eSpark-Backup/tonyajode-tabletdesign/Documents/_Images/download (1) - Copy.jpg

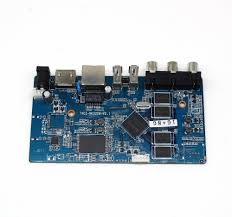
Documents/_Images/download (1) - Copy.jpg
