eSpark-Backup/tonyajode-tabletdesign/Documents/_Images/images (1).jpg

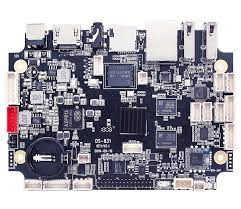
Documents/_Images/images (1).jpg
