eSpark-Backup/tonyajode-tabletdesign/README.md

# TonyAjode-TabletDesign
To develop a custom Android Tablet that meets client's requirements
## Reference Links:
### Client shared link:
https://mega.nz/folder/z5Y0XJoY#Gf70UQKzT3QTy8h_Zp9odA
### i.MX 8M refernce design links: https://media.digikey.com/pdf/Data%20Sheets/NXP%20PDFs/MCIMX8M-EVK_Schematic.pdf
### Alternate SoM:
1) https://www.compulab.com/products/computer-on-modules/ucm-imx8-nxp-i-mx-8m-som-system-on-module-computer/
2) https://www.variscite.com/product/system-on-module-som/cortex-a72/var-som-mx8-nxp-freescale-i-mx8/
### 3G modem link:
http://www.ebvnews.ru/doc16/SIM7100_DS.pdf
### Samsung GT-P6800 Galaxy Tablet schematic:
(for reference only) https://drive.google.com/file/d/1cv6nKJzWq3uBpqava95Kh4lrrErxx5Bf/view
### TI's Tablet (multimedia) ICs and reference designs:
https://www.ti.com/solution/tablet-multimedia
