eSpark-Backup/tonyajode-tabletdesign/Design-Files/Tony_Tablet.PcbDoc.htm

Reporting Options

# File in Previous Format

Date | : | 10/4/2021
Time | : | 10:42:58 AM
Filename | : | D:\eSpark\TonyAjode-TabletDesign\Design-Files\Tony_Tablet.PcbDoc

Version | Warning

This file was generated by an earlier version of the software
