eSpark-Backup/tonyajode-tabletdesign/Design-Files/Tablet_Design.PcbDoc.htm

Reporting Options

# File in Previous Format

Date | : | 8/11/2021
Time | : | 11:00:41 AM
Filename | : | D:\eSpark\TonyAjode-TabletDesign\Design-Files\Tablet_Design.PcbDoc

Version | Warning

This file was generated by an earlier version of the software
