eSpark-Backup/tonyajode-tabletdesign/Documents/Tablet Design Report.docx

# Tablet Design Report

# Current Design Description:

## 1. Power Section:

The power section is divided into three parts namely;

- MCU Core power
- USB power
- RTC Section

### a) MCU Core power:

Main Component:

ETA3451D2I-T: 6V/3.5A, Fast Response, Adaptive COT Step-Down Converter in Tiny DFN2x2

Description:

This section is responsible for supplying DC power to the core of SoM. The ETA3451D2I-T IC is being used in this section to produce 1V output. ETA3451D2I-T is a high frequency synchronous Step-Down converter with up to 91% efficiency for low output voltage and a 3.5A Max output current limit.
Link:

http://www.etasolution.com/upload/201712/15/201712151617531412.pdf

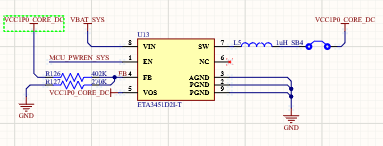
[picture p3: figure]

Figure 1

### b) USB Power Section:

Main Component:

MP3221GJ-Z IC: 2.7A, 1.2MHz, High-Efficiency Step-Up Converter with Input Disconnect

Description:

This section uses MP3221GJ-Z IC to generate input supply for the chipsets being used in the USB section. The MP3221 is a 1.2MHz frequency, 6-pin TSOT23 current mode step up converter intended for small, low power applications. It offers a disconnect feature that allows the output to be completely discharged, thus allowing the part to draw less than 1µA off current in shutdown mode. The circuit uses a feedback combination of 536K and 100K resistors to produce a 5V/1A output.

Link: https://www.monolithicpower.com/en/documentview/productdocument/index/version/2/document_type/Datasheet/lang/en/sku/MP3221/document_id/1118

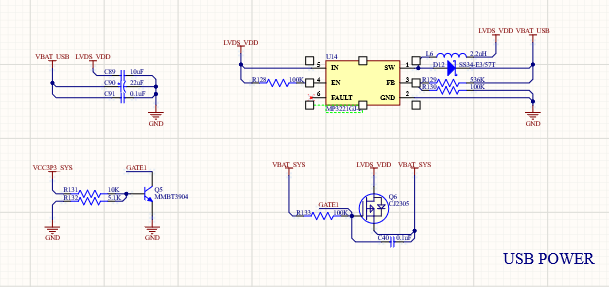
[picture p4: figure]

Figure 2

### c) RTC Section:

Main Component:

S-1206B18-M3T1U: ultra-low current consumption and low dropout CMOS voltage regulator

Description:

This section is designated to provide power to the RTC clock of the SoM. S-1206B18-M3T1U is being used to generate 1.8V output. The S-1206 Series is a positive voltage regulator with ultra-low current consumption, low dropout voltage, high-accuracy output voltage, and 250 mA output current developed based on CMOS technology. It operates at ultra-low current consumption of 1.0 A (typ.) and has built-in overcurrent protection circuit that prevents the load current from exceeding the current capacity of the output transistor.
Link:

https://www.ablic.com/en/doc/datasheet/voltage_regulator/S1206_E.pdf

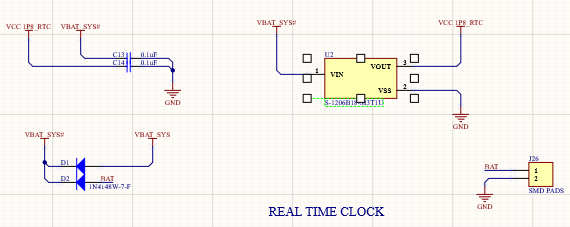
[picture p5: figure]

Figure 3

## 2. Audio Section:

Audio section deals with the input and output audio signals and is further divided into three different sections.

### a) Mic Section:

Main Component:

POM-2738P-R: Condenser mic, analogue, omni -38db 6mm d

Description:

It is the main input source of audio for the tablet. A POM-2738P-R is used which is an electret condenser type microphone and gives analogue output. The Mic output goes straight into the audio codec through MIC1P and MIC1N netlabels. MICBIAS provides power to POM-2738P-R through ALC5621.

Link:

https://www.puiaudio.com/media/SpecSheet/POM-2738P-R.pdf

Figure 4

### b) Audio Codec Section:

Main component:

ALC5621: I2S audio codec + 1.3w class ab/d mono speaker amplifier + headphone amplifier

Description:

The ALC5621 is a highly-integrated I2S/PCM interface audio codec with multiple input/output ports and is designed for mobile computing and communications. This IC will be used in the audio codec section to provide good quality sound output. It also has a Stereo Hi-Fi DAC for playback and Stereo ADC for recording via the I2S/PCM interface. The chip is connected to SoM via I2S interface in our design.
The ALC5621 AVDD operates at supply voltages from 2.3V to 3.6V. DVDD operates from 1.71 to 3.6V, and SPKVDD operates from 2.3 to 5V. To extend battery life, each section of the device can be powered down individually under software control. Leakage current in maximum power saving state is less than 10μA.

Link:

https://mega.nz/folder/z5Y0XJoY#Gf70UQKzT3QTy8h_Zp9odA/folder/O04ixZyI

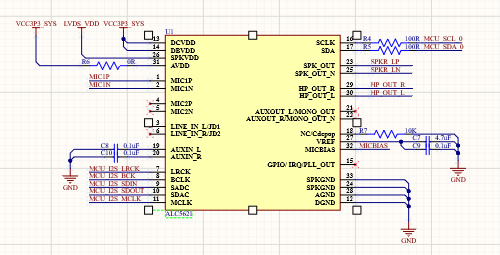
[picture p6: figure]

Figure 5

### c) Headphone Section:

Main Component:

SJ-43504-SMT-TR: mid mount audio jack

Description:

This section has a SJ-43504-SMT-TR audio jack for Stereo headphone output. The output signal HP_OUT_L and HP_OUT_R goes directly to this connector. The audio jack is powered up with a 3.3V supply from VCC3P3_SYS signal from X4418.

Link:

https://www.cuidevices.com/product/resource/sj-43504-smt-tr.pdf

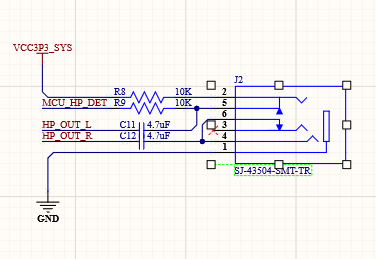
[picture p7: figure]

Figure 6

## 3. 3G Section:

Main Component:

SIM7100: multi-band TDD-LTE/FDD-LTE/WCDMA/GSM/GNSS SMT type module.

693043020611: 6 Position Card Connector NANO SIM Surface Mount, Right Angle Gold

Description:

We are using SIM7100AS2-10671 as a 3G modem in this tablet. The module is powered up directly through the battery. Some multilayer ceramic chip (MLCC) capacitors (0.1/1uF) with low ESR in high frequency band can be used for EMC.

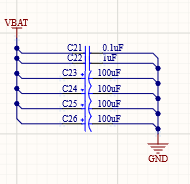
[picture p8: figure]

Figure 7

SIM7100 has a 1.8V I/O level. To match the I/O levels of SoM which operate at 3.3V, level shifters are being used to bridge signals between the two devices.

Figure 8

2 UFL connectors are provided to connect the main and GNNS antenna for proper RF connectivity.

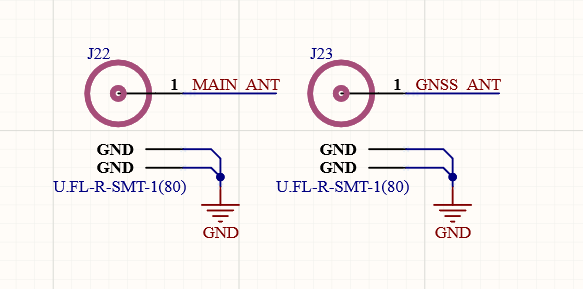
[picture p9: figure]

Figure 9

Module is able to make and receive voice calls, data calls, SMS and make GPRS/WCDMA/HSPA+/LTE traffic. For this purpose, 693043020611 ESIM has been attached on the PCB with proper ESD protection as shown below.

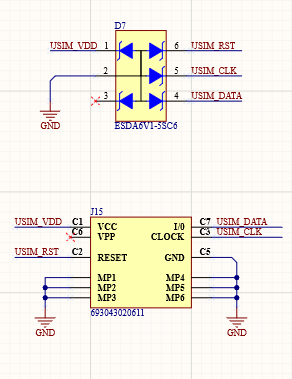
[picture p10: figure]

Figure 10

The SIM7100 module is communicating with the G4418 SoM via USB interface. The SIM7100 contains a USB interface compliant with the USB2.0 specification as a peripheral, but the USB charging function is not supported. The connections are made with proper ESD protection diodes.

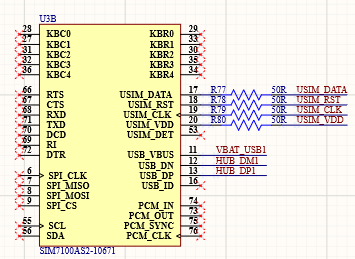
[picture p11: figure]

Figure 11

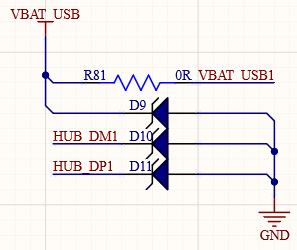
[picture p12: figure]

Figure 12

Link:

https://www.we-online.de/katalog/datasheet/693043020611.pdf

http://www.ebvnews.ru/doc16/SIM7100_DS.pdf

## 4. Main Processing Section:

The choice of CPU is one of the critical decisions of all. It is the brain of the entire module, driving all the I/O peripherals, display and touch screen etc. With the ongoing digitization and introduction of more complex systems, old embedded chips are being replaced by advanced systems and modules. One such unique product is a System on Module.
We are using X4418 module in this tablet which consists of S5P4418 SoM, AXP228 PMIC, and some memory chips.

### a) Overview of S5P4418 SoM:

The module used in the design is the X4418 board equipped with Samsung S5P4418 system on module, AXP228 PMIC and memory chips as main elements. The SoM is high performance, cost effective and low power embedded system CPU module and uses a 32-bit RISC processor which makes it suitable to be embedded in tablet pc, mobile phones, cars, learning machine, POS machine, game machine, industry monitoring and many other projects.

### b) Key Features:

Following are some core features of the processing module.

CPU: | ARM Cortex-A9 Quad-Core
Speed: | 1.4 GHz
Memory | LPDDR1, LPDDR2, DDR2 and DDR3
EMMC | 8GB(Default) (4GB and 16GB optional)
Multi-media decode | H.263, H.264, MPEG1, MPEG2, MPEG4, VC1, VP8, Theora, AVS, RV8/9/10, MJPEG
Multi-media codec | H.263, H.264, MPEG4, MJPEG
Max resolution | 2048*1280
ADC | 8 channel 12 bit 0~1.8V
RAM | 1GB DDR3

The ARM Cortex-A9 Quad-Core is 50% faster than the Cortex-A8-core. It provides a 6.4 GB/s memory bandwidth for heavy traffic operations such as a 1080p video encoding and decoding, 3D graphics display and high-resolution image signal processing with full HD display. Software designers can fully access the memory resources as the processor supports dynamic virtual address mapping.

The module supports Dual Display up to 2048x1280, TFT-LCD, LVDS, HDMI 1.4a, MIPI-DSI output. It also provides a 3.3V output voltage at it's GPIOs which is quite commonly used among other integrated devices. Hence the device can be interfaced with a wide range of other chips sets. The Samsung S5P4418 has various boot modes including External Static Memory Boot, SPI Flash/EEPROM, NOR, USB and UART boot options.

### c) Available Interfaces:

The X4418 module supports 3ch I2S, SPDIF Rx/Tx, 3ch I2C, 3ch SPI, 8ch 12bit ADC, 3ch PWM and GPIOs, 1ch PPM. It also offers 1ch USB 2.0 Host, 1ch USB 2.0 OTG, 1ch USB HSIC Host.

### d) Software compatibility:

The Samsung S5P4418 system on module support three main operating systems: android4.4.2 OS, linux3.4.39 + QT5.4 system and ubuntu12.04.

### e) Electrical characteristics:

Some important voltage and current rating values are mentioned below:

Signal Description | Typical value
DC supply voltage for CORE | 1-1.2V
DC supply voltage for RTC | 1.8V
DC supply voltage for 3.3V IO | 3.3V
DC supply voltage for 2.8V VID0, VID2/SD2, Ethernet MAC | 2.8V
DC In/Out Current | 20mA max

### f) SoM Power Section:

The G44418 module uses AXP228 PMIC optimized for a multi-core high-performance system. It is designed to charge a single cell Li-battery (Li-ion or Li-polymer) application that requires multi-channel power conversion outputs. AXP228 comes with an adaptive USB3.0-compatible Flash Charger that supports up to 94% efficiency and 2.2A charge current.

What are the main features of PMIC?

It provides an easy and flexible power management solution for multi-core processors to meet the increasingly complex and accurate requirements of power control. AXP228 provides multiple-channel 12-bit ADC for voltage/current/temperature monitoring and integrates protection circuits such as OVP, UVP, OTP, and OCP. The VOUT current available before loading the battery is 3A.

How does the charging process work?

When the battery voltage is lower than 3.0V, the charger will change to pre-charge mode, where the charge current is 1/10 of a pre-set current value. If the battery voltage fails to reach 3.0V within 40 mins (adjustable in REG34H) the charger will automatically enter battery activation mode. Once the battery voltage is above 3.0V, the charger will enter constant current charge mode.

The charging current is 2.2A whereas VCC3V3_SYS is the 3.3V output which provides up to 1.4A current.

## 5. Camera Section:

Main Component:

0524352471: 24 position 0.5mm FPC connector

Description:

The camera section is currently designed for a single rear camera of the tablet. It uses a 0524352471 FPC connector to place in the camera. The camera signals directly connect to the SoM camera input pins. The G4418 development board has provided a single 24PIN DVP camera interface which is implemented in the current circuit. It is capable of supporting OV and HIMAX cameras.

Link:

https://www.molex.com/pdm_docs/sd/524352471_sd.pdf

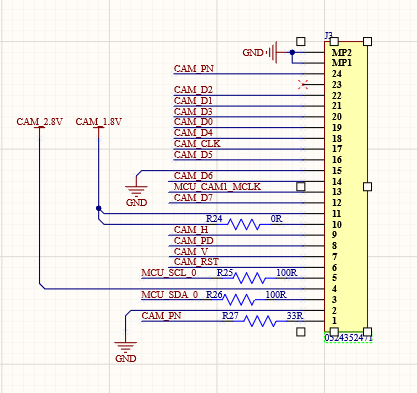
[picture p13: figure]

Figure 13

## a) Key points to consider:

- Block diagram shows 2 cameras of 2MP and 5MP for front and rear view respectively. Rear camera should have a I2C interface and the front camera should be connected through MCS1. If two cameras are required then an extra connector needs to be added.

Some options for camera selection are mentioned below.

- Link 1: https://www.sparkfun.com/products/15570
- Link 2: https://www.aliexpress.com/item/32843271086.html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 (Front)
- Back 5MP: https://www.aliexpress.com/item/33029896473.html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

## 6. LCD Section:

Currently, the design supports an RGB LCD. An FPC connector 4-1734592-2 is attached as an LCD matting connector. All pins are connected to the SoM. The SoM also supports the LVDS interface for LCDs. Depending on the selection of LCD, a dedicated backlight driver might be required.

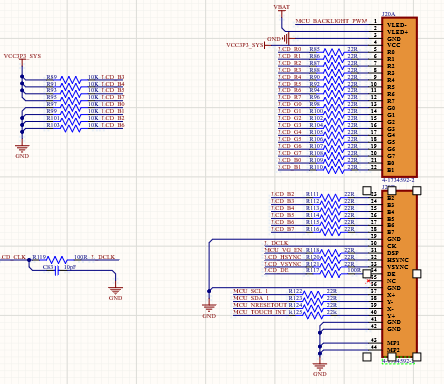
[picture p14: figure]

Figure 14

### Compatible LCDs:

Here are some options from the client's suggested IC that can be used for designing a tablet.

- AT043TN24 V.1 with touch panel: https://www.aliexpress.com/item/32560082998.html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,searchweb201602_,searchweb201603 (RGB)
- NT116WHM-N10: https://www.aliexpress.com/item/32878065947.html (LVDS based, need to change pin configuration for this one)
- HSD050IDW1-A: https://www.aliexpress.com/item/32811367794.html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,searchweb201602_,searchweb201603_ (without touch screen digitizer)

https://www.aliexpress.com/item/33041667425.html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,searchweb201602_,searchweb201603_ (with touch screen digitizer)

## 7. Memory Section:

The memory section encompasses two SD card connectors 114-00841-68 which will be connected to the relevant pins of G4418 SoM. The connectors are powered through the 3.3V supply provided by the power section of the SoM. All data signals of the SD card are pulled up using a 47K resistor array.

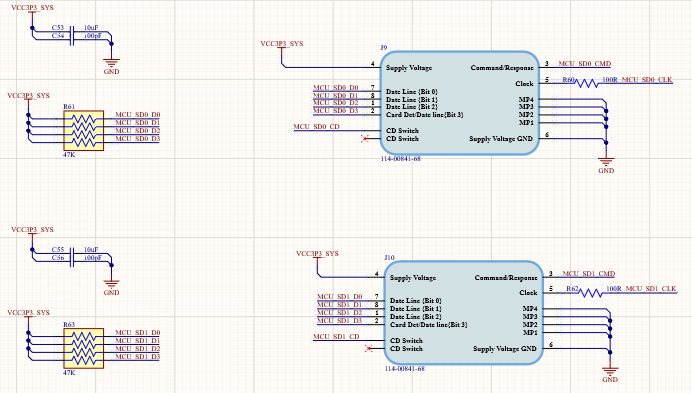
[picture p15: figure]

Figure 15

## 8. USB Section:

The USB section is divided into the following sub sections.

- USB Host Section
- USB OTG section

At present, there is one USB OTG channel and 3 USB host channels available.

### a) USB Host Section:

Main Component:

GL850G: USB 2.0 Hub Controller

87583-2010BLF: USB-A (USB TYPE-A) USB 2.0 Receptacle Connector 4 Position Surface Mount, Right Angle

Description:

This section would serve as a “master” USB device, to which other “client” peripherals can be attached. 3 USB Tyoe A connectors 87583-2010BLF are present in the schematic and are only connected to USB host IC. The GL850G USB host IC is being used which embeds an 8-bit RISC processor to manipulate the control/status registers and respond to the requests from the USB host. Since the pins are bidirectional, 3 channels of host IC are connected to micro-USB connectors and the remaining two channels, DX0 and DX1, are connected to MCU and 3G modem respectively.

Link:

https://datasheet.lcsc.com/szlcsc/Genesys-Logic-GL850G-HHY22_C136617.pdf

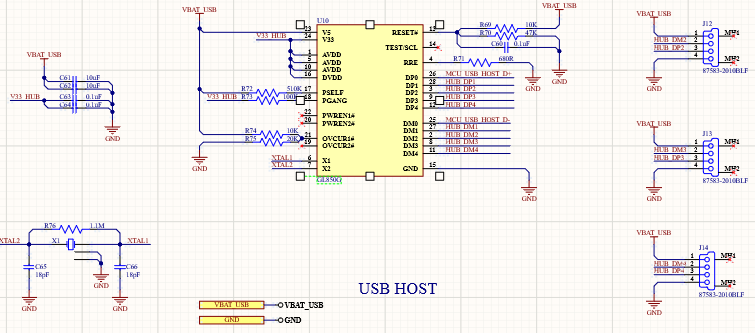
[picture p16: figure]

Figure 16

### b) USB OTG section:

Main Components:

SY6280: power distribution switch

10118194-0001LF: micro–B USB 2.0 receptacle connector

Description:

With USB On-The-Go, you can connect external peripheral devices to this tablet such as keyboard and storage devices. We are using the SY6280 chipset which is a low loss power distribution switch. The USB input uses a 10118194-0001LF micro–B USB 2.0 receptacle connector.

The SY6280 will receive 5V from the USB power section. This will control supply to the OTG and will be controlled by the main processing unit.

Link:

https://img.ozdisan.com/ETicaret_Dosya/470612_2154920.PDF

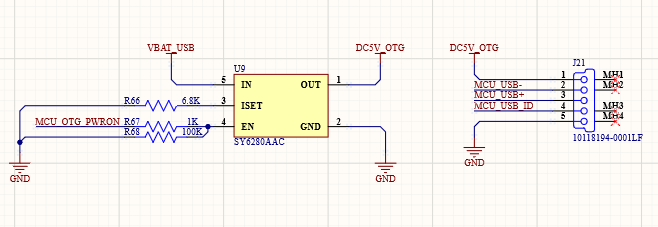
[picture p17: figure]

Figure 17

## 9. Input Section:

Input section consists of the following sub sections:

- Keys Button Section
- Sensor Section

### a) Keys Button Section:

Main Component:

TL3301NF160QG/TR: Tactile Switch SPST-NO Top Actuated Surface Mount

Description:

The tablet will have TL3301NF160QG/TR as 2 volume keys, a power button and a reset switch which are provided in this section. Switches for back and menu function are also given.

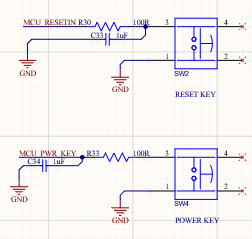
[picture p18: figure]

Figure 18

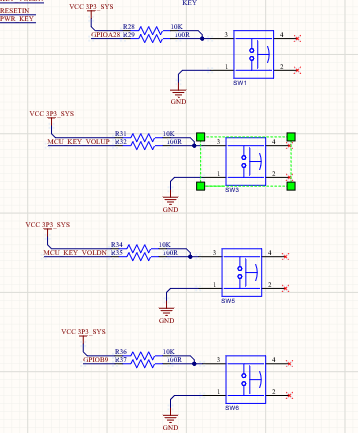
[picture p19: figure]

Figure 19

### b) Sensor Section:

Main Components:

ICM-42688-P: 6 axis IMU senor

VEML6030-GS15: light sensor IC

Description:

The tablet currently has a 6 axis IMU sensor ICM-42688-P and a light sensor VEML6030-GS15. Both sensors are connected through the I2C 2 interface of the SoM with different address lines.

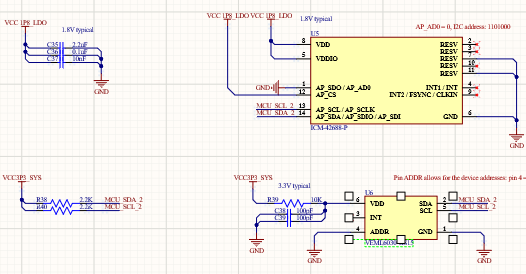
[picture p20: figure]

Figure 20

According to the block diagram a compass is also required which needs to be added.

Figure 21

Link:

https://www.vishay.com/docs/84366/veml6030.pdf

https://product.tdk.com/system/files/dam/doc/product/sensor/mortion-inertial/imu/data_sheet/ds-000347-icm-42688-p-v1.2.pdf

## 10. Connector Section:

Main Component:

DC-005-5A-2.5-SMT: DC barrel jack

0527460471: FPC connector

Description:

The connector section consists of all the important connectors for input power. We have added a DC barrel jack DC-005-5A-2.5-SMT for power adapter and an FPC connector 0527460471 and SMD pads for battery input. The input is connected to necessary bulk capacitance for a stable supply. Battery is expected to be 3.7V Lipo whereas the adaptor will provide 5V power input. The input signals from this section connect to the main controller section which has a built-in power management circuitry with battery charging facility.

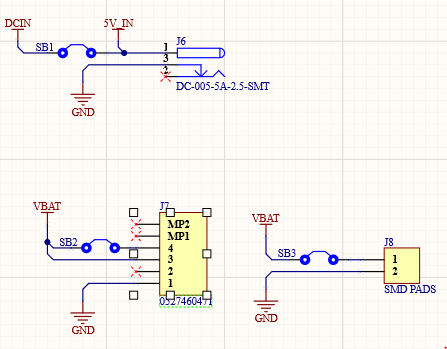
[picture p21: figure]

Figure 22

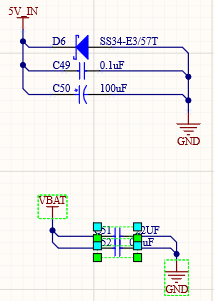
[picture p22: figure]

Figure 23

# Missing Characteristics Of the System:

Following components/circuits needs to be added to the current design as per the instructions given in block diagram provided by client.

- Another camera interface needs to be added for front view.
- Backlight LED driver depending on the choice of LCD.
- Debug FPC connector needs to be added.
- There should be a speaker connected to the audio codec.
- There is no Bluetooth or WiFi feature available in the design.
- Not enough GPIOs are available for connecting SIM7100. The RESET pin, PWRKEY (which enables the module) and flight mode pin (which controls RF function) are not connected to the SoM.
- Extra SD card connector needs to be removed from the design. The tablet can work well with a single SD card.

# Alternate Suggestions for SoM G4418:

Here are some other efficient alternates to the current processing unit being used in the design.

## 1. VAR-SOM-MX6:

### a) Overview:

The VAR-SOM-MX6 is a high-performance System-on-Module. It provides an ideal building block that easily integrates with a wide range of target markets requiring rich multimedia functionality, powerful graphics and video capabilities, as well as high-processing power. Compact, cost effective and with low power consumption, VAR-SOM-MX6 secures an Intel Atom performance level.

Datasheet Link: https://www.variscite.com/wp-content/uploads/2017/12/VAR-SOM-MX6_datasheet.pdf
Reference Design: https://www.variscite.com/wp-content/uploads/2017/12/V2_VAR-MX6CustomBoard-Schematics.pdf

### b) Key Features:

- Freescale i.MX6 series SoC (Single/Dual/Quad/Quad Plus ARM® Cortex™-A9 Core, 1.2 GHz)
- Up to 4GB DDR3 RAM
- Up to 1GB NAND Flash for storage memory / boot
- Up to 64GB eMMC storage
- 2 x LVDS display interface
- HDMI V1.4 interface
- 1 x MIPI DSI.
- Touch panel interface.
- Parallel & serial camera interface
- On-board 10/100/1000 Mbps Ethernet PHY
- TI WiLink8 2.4/5GHz WLAN (802.11 a/b/g/n) / BT-BLE 4.1 with CSA2 support
- and optional MIMO
- 1 x USB 2.0 host, 1 x OTG
- 1 x SD/MMC.
- Serial interfaces (SPI, I2C, UART, I2S,)
- CAN Bus.
- Stereo line-In / headphones out
- Digital microphone
- Single 3.3 V power supply
- 67mm x 51mm, 200 pin SO-DIMM Connector

### c) Advantages over G4418 module:

Here are some plus points of using the Var-SoM-MX6:

- The module has TLV320AIC3106 which is a low-power, highly integrated stereo audio codec with stereo headphone amplifier, as well as multiple inputs and outputs programmable in single-ended or fully differential configurations The VAR-SOM-MX6 exposes the following interface of the TLV320AIC3106:
1. Headphone
2. Line-in
3. Digital microphone
- The VAR-SOM-MX6 contains TI’s WL183xMOD WiLink, a high performance 2.4/5 GHz IEEE 802.11 a/b/g/n Bluetooth 4.1/BLE with CSA2 support radio module, with optional Dual Band and MIMO support. The modules support improved performance over WiFi in bit rates reaching 100Mbps (UDP) and 80Mbps (TCP).
- The VAR-SOM-MX6 features Freescale’s PMPF0100 as a Power Management Integrated circuit (PMIC) which regulates all power rails required on SoM from a single 3.3 V power supply. The PMIC is fully programmable via the I2C interface.
- The VAR-SOM-MX6 exposes a 200-pin SO–DIMM mechanical standard interface. The recommended mating connector for baseboard interfacing are:

1. CONCRAFT - 0701A0BE52E

2. Tyco Electronics-1565917-4

In addition to the 200-pin SO-DIMM interface VAR-SOM-MX6 exposes a 40-pin FFC connector. The recommended mating cable is Molex 21020-0427 or equivalent.

- The VAR-SOM-MX6 features a 4-wire resistive touch panel interface which is compatible with 4-wire resistive touch screens, pen-detection and nIRQ generation and supports several schemes of measurement, averaging to filter noise.
- The SoM supports JTAG for debugging and test controlling with maximum security
- It has a 4GB of DDR3 compared to a 1GB DDR3 of G4418 and a 64GB eMMc compared to 8GB in G4418. : The VAR-SOM-MX6 is available with up to 1GB of SLC NAND FLASH memory.

## 2. UCM-iMX8:

### a) Overview:

UCM-iMX8 is an ultra-miniature form-factor and high efficiency module which is ideal for space constrained and portable systems. The module uses i.MX 8M family of processors features advanced implementation of a quad ARM® Cortex®- A53 core, which operates at speeds of up to 1.5 GHz. A general-purpose Cortex®-M4 core processor is for low-power processing.

### b) Key Features:

Features | Details
Core | ARM Cortex-A53 MPCore (Quad-core)
Co-processor | ARM Cortex-M4
RAM | 4GB LPDDR4
eMMc | 64GB
Networks | Ethernet port, WiFi 802.11ac, BT 4.1
I/Os | 2x PCIe, 2x USB3.0, 4x UART, 3xSPI, 3xI2C, 4xPWM, 1xMMC/SD/SDIO, 95x GPIO
Camera | MIPI-CSI, 4 lanes
System Logic | RTC with ext batt and JTAG debug interface
Miniature size | 28 x 40 x 5 mm

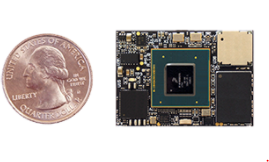
[picture p23: figure]

### c) Block Diagram:

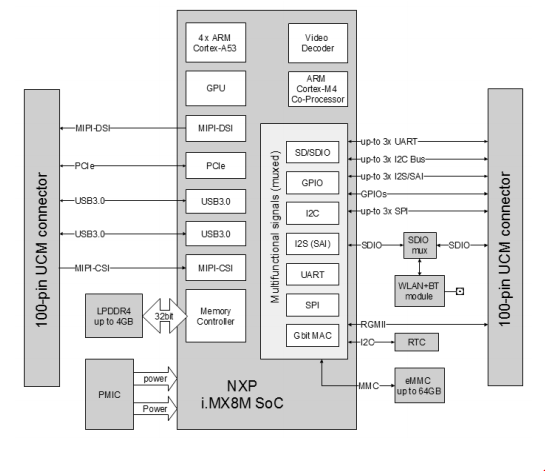
[picture p24: figure]

### d) Power supply:

There are two main signals for input power.

Connecting V_SOM:

The main power supply voltage (V_SOM) of UCM_iMX8 requires 3.8V to function. We can hook it up with a battery directly to provide input power. Several 10/100uF capacitors will be connected between V_SOM and GND for a stable input signal.

Connecting VCC_RTC:

A battery charging circuitry would be required. The RTC requires 3V on VCC_RTC pin which will be provided through an external battery source.

### d) Advantages over G4418 module:

Here are some plus points of using the Var-SoM-MX6:

- It is equipped with WiFi 802.11 a/b/g/n and Bluetooth functionality
- The board can either be connected to a regulator or battery for 3.8V.
- Extra GPIOs are given. Additional functions can easily be connected.
- It has more memory and RAM than the current module being used in the design. RAM is 4GB and eMMc is 64GB compared to 1GB and 8GB in X4418 board, respectively.
- Miniature size reduces the overall size of the PCB allowing for a compact design.
