eSpark-Backup/tonyajode-tabletdesign/Deliverables/Core Production Files/Renderings/2d_Top.jpg

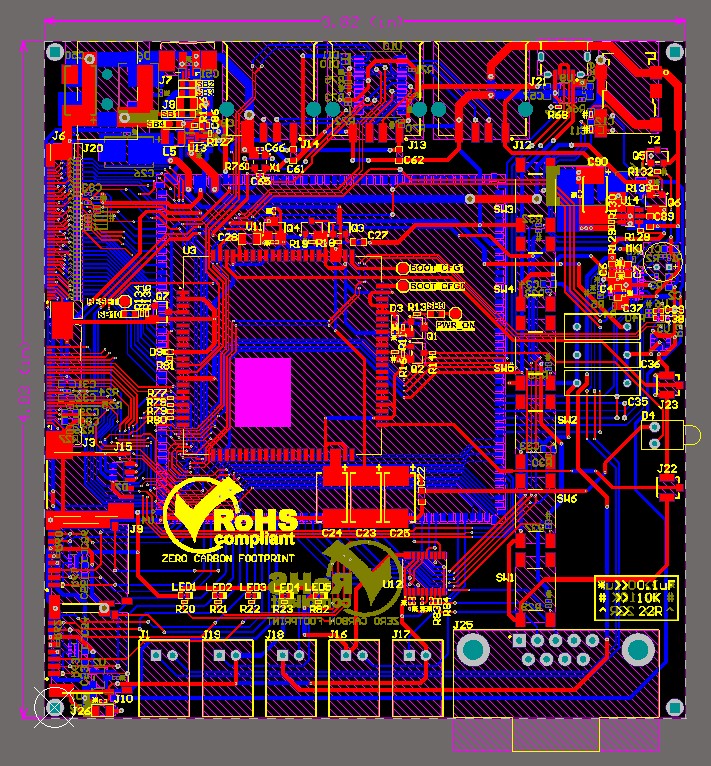
Deliverables/Core Production Files/Renderings/2d_Top.jpg
