eSpark-Backup/tonyajode-tabletdesign/Deliverables/Core Production Files/Renderings/3D_Bottom.jpg

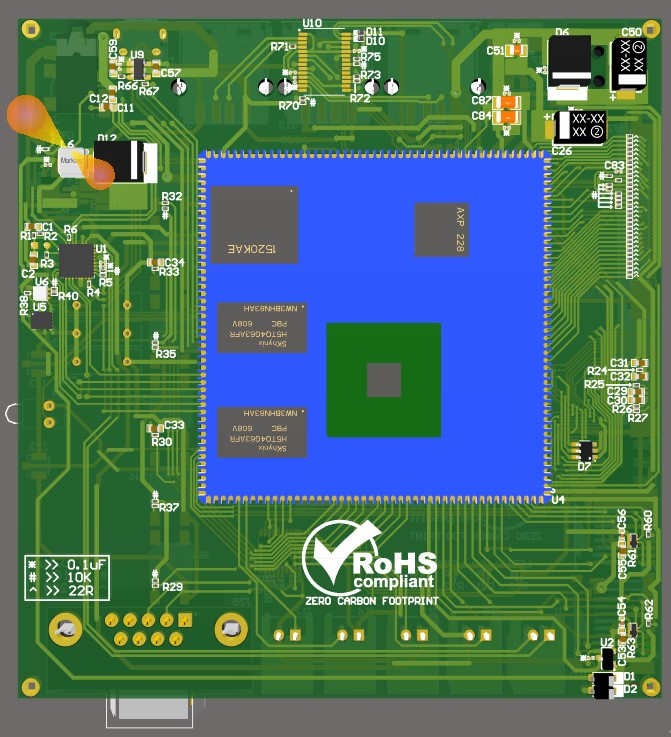
Deliverables/Core Production Files/Renderings/3D_Bottom.jpg
