eSpark-Backup/tonyajode-tabletdesign/Deliverables/Core Production Files/Renderings/3D_Top.jpg

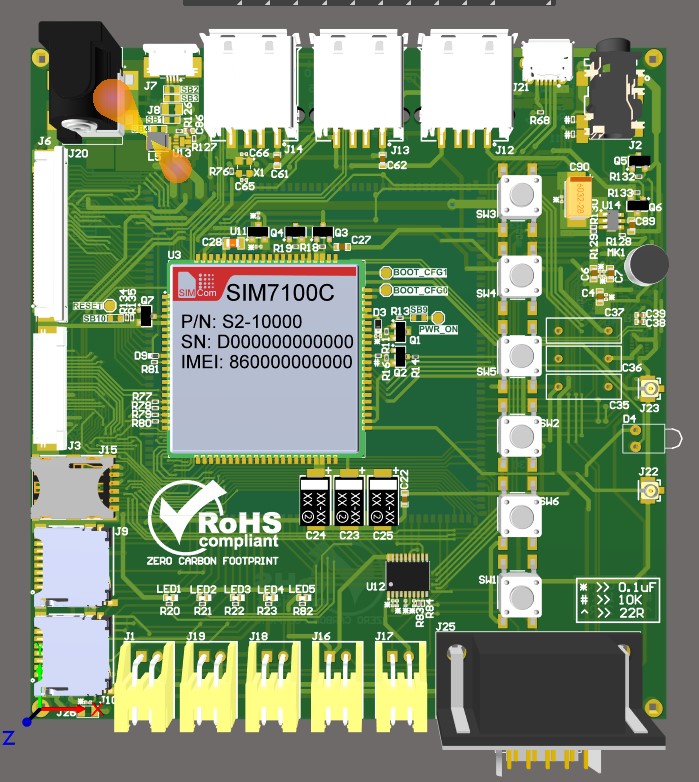
Deliverables/Core Production Files/Renderings/3D_Top.jpg
