eSpark-Backup/tonyajode-tabletdesign/Documents/_Images/download (2).jpg

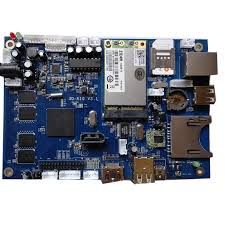
Documents/_Images/download (2).jpg
