eSpark-Backup/tonyajode-tabletdesign/Documents/_Images/download.jpg

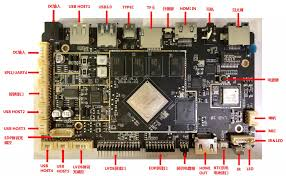
Documents/_Images/download.jpg
