eSpark-Backup/tonyajode-tabletdesign/Documents/_Images/HTB1_i4uRVXXXXbiXpXXq6xXFXXXl.jpg

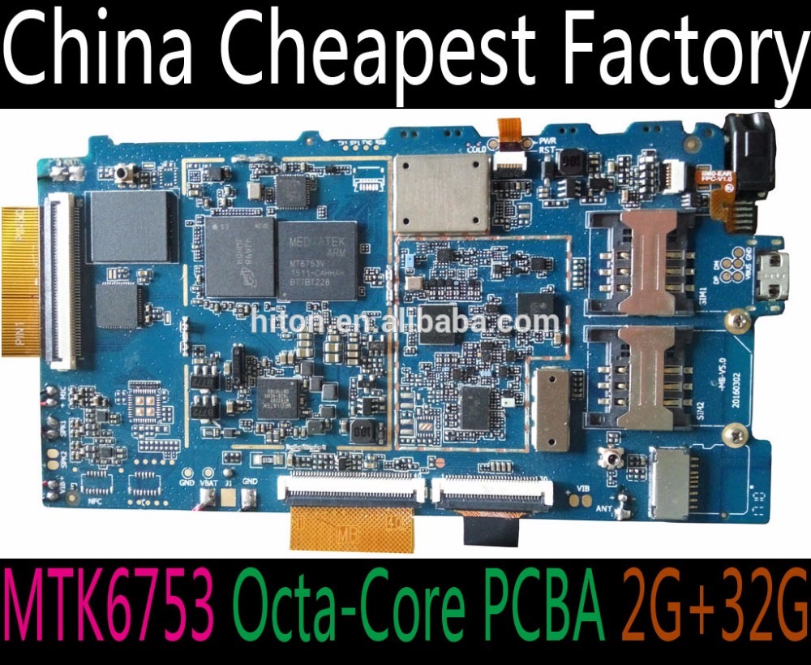
Documents/_Images/HTB1_i4uRVXXXXbiXpXXq6xXFXXXl.jpg
