eSpark-Backup/tonyajode-tabletdesign/Documents/_Images/HTB1J5LBJ4naK1RjSZFtq6zC2VXaV.jpg

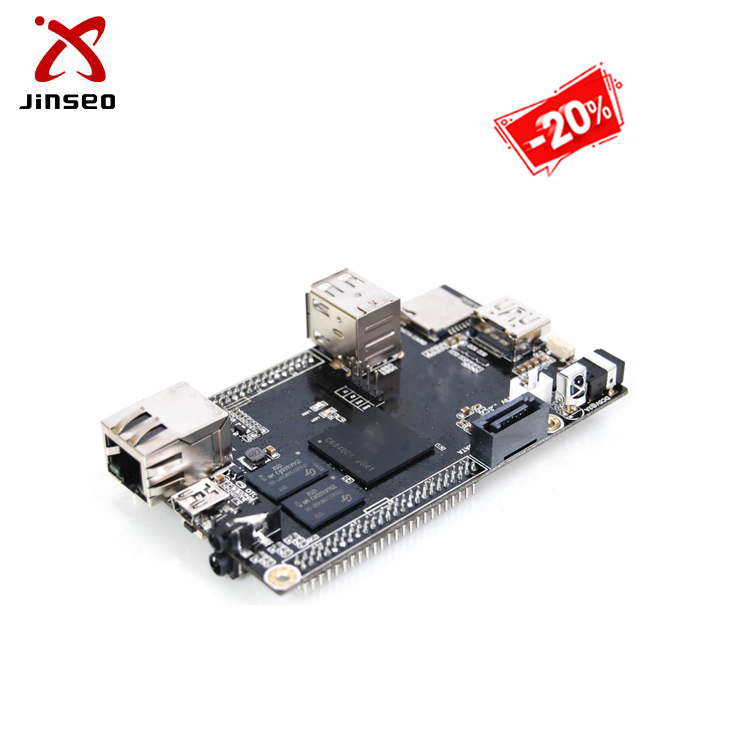
Documents/_Images/HTB1J5LBJ4naK1RjSZFtq6zC2VXaV.jpg
