eSpark-Backup/tonyajode-tabletdesign/Documents/_Images/images (2).jpg

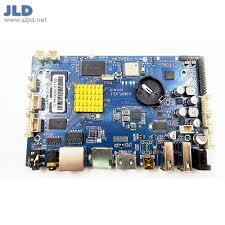
Documents/_Images/images (2).jpg
