eSpark-Backup/tonyajode-tabletdesign/Documents/_Images/images.jpg

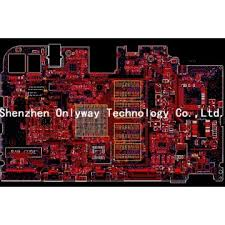
Documents/_Images/images.jpg
