eSpark-Backup/tonyajode-tabletdesign/Documents/_Images/imx6-sbc(1).jpg

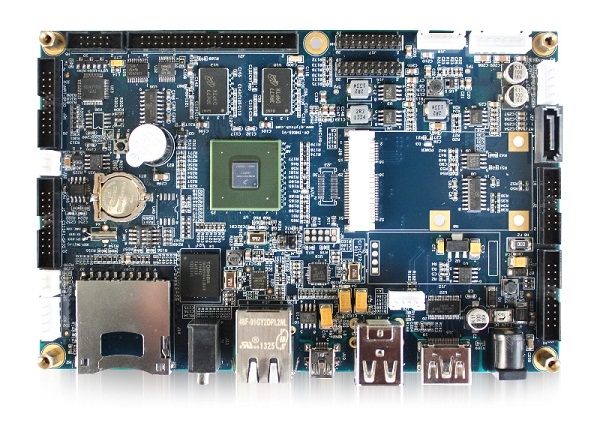
Documents/_Images/imx6-sbc(1).jpg
