eSpark-Backup/tonyajode-tabletdesign/Documents/_Images/OEM-android-PCB-tablet-circuit-board-for-advertising-display-embedded-motherboard.jpg

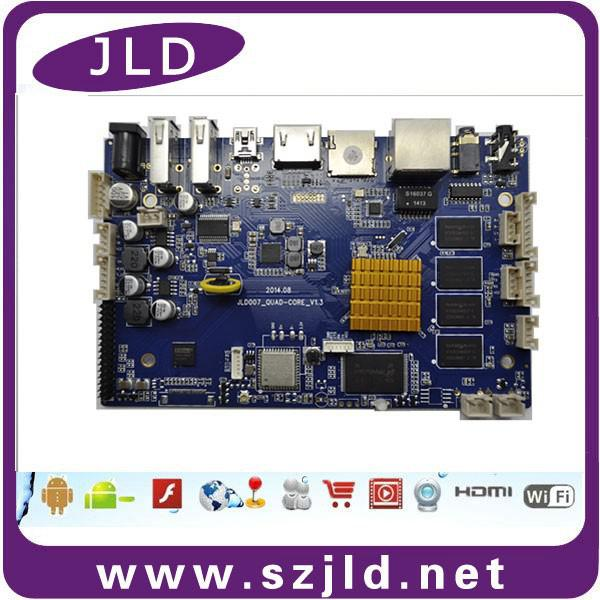
Documents/_Images/OEM-android-PCB-tablet-circuit-board-for-advertising-display-embedded-motherboard.jpg
