eSpark-Backup/tonyajode-tabletdesign/Deliverables/Core Production Files/BOM/Digikey BOM_Tony Ajode.xlsx

Bill of Material (BOM) for Tony Ajode
S. No. | Components | Description | Designator | Footprint (Package) | Manufacturer Part Number | Manufacturer | Alternate | Value | Link | Quantity (Per Board) | Quantity 6 | Unit Price/Per Board | Total Price/Per Board | Unit Price/6 Boards | Total Price/6 Board | Remarks
1 | Capacitor | CAP CER 4.7UF 25V X5R 0603 | C1, C7, C11, C12, C69, C72 | Cap0603 | C1608X5R1E475M080AC | TDK Corporation | ------------- | 4.7uF | Digikey (https://www.digikey.com/en/products/detail/tdk-corporation/C1608X5R1E475M080AC/3648583) | 6 | 36 | $0.3800 | $2.28 | $0.2580 | $9.29
2 |  | CAP CER 1UF 25V X5R 0603 | C2, C16, C22, C29, C31, C33, C34, C43, C44, C45, C47 | Cap0603 | CC0603KRX5R8BB105 | AVX Corporation | CC0603MRX5R8BB105 | 1uF | Digikey (https://www.digikey.com/en/products/detail/yageo/CC0603MRX5R8BB105/5195230) | 11 | 66 | $0.0880 | $0.97 | $0.0498 | $3.29
3 |  | CAP CER 0.1UF 25V X6S 0201 | C3, C5, C8, C9, C10, C13, C14, C15, C18, C21, C36, C37, C40, C42, C46, C48, C49, C52, C56, C58, C60, C63, C64, C67, C71, C77, C78, C79, C80, C81, C82, C85, C88, C91 | CAP 0201 | GRM033C81E104KE14D | Murata Electronics | ------------- | 0.1uF | Digikey (https://www.digikey.com/en/products/detail/murata-electronics/GRM033C81E104KE14D/5027488) | 34 | 204 | $0.0530 | $1.80 | $0.0237 | $4.83
4 |  | CAP CER 10UF 35V X5R 0603 | C4, C6, C17, C27, C30, C32, C35, C53, C57, C59, C61, C62, C89 | Cap0603 | GRM188R6YA106MA73D | Murata Electronics | ------------- | 10uF | Digikey (https://www.digikey.com/en/products/detail/murata-electronics/GRM188R6YA106MA73J/8346265) | 13 | 78 | $0.4500 | $5.85 | $0.2202 | $17.18
5 |  | CAP 1.2pF 50V, 0603 | C19, C20 | Cap0603 | CC0603BRNPO9BN1R2 | YAGEO | ------------- | 1.2pF | Digikey (https://www.digikey.com/en/products/detail/yageo/CC0603BRNPO9BN1R2/5883418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) | 2 | 12 | $0.1200 | $0.24 | $0.0870 | $1.04
6 |  | CAP TANT 100UF 10% 16V 2917 | C23, C24, C25, C26, C50 | Custom | 593D107X9016D2TE3 | Vishay Sprague | ------------- | 100uF | Digikey (https://www.digikey.com/en/products/detail/vishay-sprague/593D107X9016D2TE3/1559454) | 5 | 30 | $1.0700 | $5.35 | $0.8120 | $24.36
7 |  | CAP CER 22UF 25V X5R 0805 | C28, C51 | Cap0805 | C2012X5R1E226M125AC | Venkel | C0805X5R250-226MNE | 22UF | Digikey (https://www.digikey.com/en/products/detail/venkel/C0805X5R250-226MNE/12333402) | 2 | 12 | $0.1200 | $0.24 | $0.1200 | $1.44
8 |  | CAP CER 100PF 50V C0G/NP0 0402 | C38, C39, C54 | Cap0402 | GCM1555C1H101JA16D | Murata Electronics | ------------ | 100pF | Digikey (https://www.digikey.com/en/products/detail/murata-electronics/GCM1555C1H101JA16D/4903548) | 3 | 18 | $0.1000 | $0.30 | $0.0260 | $0.47
9 |  | CAP CER 10000PF 50V X7R 0402 | C41 | Cap0402 | GRM155R71H103KA88J | Murata Electronics | ------------ | 10nF | Digikey (https://www.digikey.com/en/products/detail/murata-electronics/GRM155R71H103KA88J/2610922) | 1 | 6 | $0.1000 | $0.10 | $0.1000 | $0.60
10 |  | CAP 2.2UF 35V X5R 20% 0402 | C55 | Cap0402 | GRM155R6YA225ME11D | Murata Electronics | ----------- | 2.2uF | Digikey (https://www.digikey.com/en/products/detail/murata-electronics/GRM155R6YA225ME11D/9867921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) | 1 | 6 | $0.2900 | $0.29 | $0.2900 | $1.74
11 |  | CAP CER 18PF 50V C0G/NP0 0201 | C65, C66 | CAP 0201 | GCM0335C1H180FA16D | Murata Electronics | ----------- | 18pF | Digikey (https://www.digikey.com/en/products/detail/murata-electronics/GCM0335C1H180FA16D/11618782) | 2 | 12 | $0.1000 | $0.20 | $0.0650 | $0.78
12 |  | CAP CER 4.7PF 50V C0G/NPO 0603 | C68 | Cap0603 | CC0603CRNPO9BN4R7 | YAGEO | ----------- | 4.7pF | Digikey (https://www.digikey.com/en/products/detail/yageo/CC0603CRNPO9BN4R7/5195149) | 1 | 6 | $0.1000 | $0.10 | $0.1000 | $0.60
13 |  | CAP CER0.22uF 25V R 10% 0603 | C70, C73 | Cap0603 | GRM188R11E224KA88D |  |  | 220nF |  | 2 | 12 |  | $0.00 |  | $0.00
14 |  | CAP CER 47UF 16V X5R 1206 | C84, C87 | Cap1206 | EMK316BBJ476ML-T | CAL-CHIP ELECTRONICS, INC. | GMC31X5R476M16NT | 47uF | Digikey (https://www.digikey.com/en/products/detail/cal-chip-electronics-inc/GMC31X5R476M16NT/12698052) | 2 | 12 | $0.4500 | $0.90 | $0.4500 | $5.40
15 |  | CAP CER 22PF 50V C0G/NPO 0402 | C86 | Cap0402 | CC0402JRNPO9BN220 | YAGEO | ----------- | 22pF | Digikey (https://www.digikey.com/en/products/detail/yageo/CC0402JRNPO9BN220/302752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) | 1 | 6 | $0.1000 | $0.10 | $0.1000 | $0.60
16 |  | CAP TANT 22UF 10% 25V 2312 | C90 |  | T491C226K025AT | KEMET | ----------- | 22uF | Digikey (https://www.digikey.com/en/products/detail/kemet/T491C226K025AT/818606) | 1 | 6 | $0.8700 | $0.87 | $0.8700 | $5.22
17 | Diode | DIODE GEN PURP 100V 300MA SOD123 | D1, D2 | SOD-123 | 1N4148W-7-F | Diodes Incorporated | ---------- | ------- | Digikey (https://www.digikey.com/en/products/detail/diodes-incorporated/1N4148W-7-F/814371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) | 2 | 12 | $0.1800 | $0.36 | $0.1680 | $2.02
18 |  | TVS DIODE 15V 34V SOD523 | D3 | SOD-523 | ESDA18-1K | STMicroelectronics | ---------- | ------- | Digikey (https://www.digikey.com/en/products/detail/stmicroelectronics/ESDA18-1K/2440267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) | 1 | 6 | $0.5100 | $0.51 | $0.5100 | $3.06
19 |  | Typical RED GaAs LED | D4 | LED-1 | LED1 |  |  | ------- |  | 1 | 6 |  | $0.00 |  | $0.00
20 |  | Diode Schottky 30V 0.35A 2-Pin SOD-123 T/R | D5 | SOD-123 | SD103BW-7-F | Diodes Incorporated | -------- | ------- | Digikey (https://www.digikey.com/en/products/detail/diodes-incorporated/SD103BW-7-F/1935417) | 1 | 6 | $0.4400 | $0.44 | $0.4400 | $2.64
21 |  | DIODE SCHOTTKY 40V 3A DO214AB | D6, D12 | SMC | SS34-E3/57T | Vishay General Semiconductor - Diodes Division | -------- | ------- | Digikey (https://www.digikey.com/en/products/detail/vishay-general-semiconductor-diodes-division/SS34-E3-57T/1091554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) | 2 | 12 | $0.2768 | $0.55 | $0.2768 | $3.32
22 |  | TVS DIODE 3V SOT23-6 | D7 | SOT-23-6 | ESDA6V1-5SC6 | STMicroelectronics | --------- | ------- | Digikey (https://www.digikey.com/en/products/detail/stmicroelectronics/ESDA6V1-5SC6/1037983) | 1 | 6 | $0.5700 | $0.57 | $0.5700 | $3.42
23 |  | TVS DIODE 5V 9.8V SOD923 | D9, D10, D11 | SOD-923 | ESD9L5.0ST5G | onsemi | --------- | ------- | Digikey (https://www.digikey.com/en/products/detail/onsemi/ESD9L5-0ST5G/1693175) | 3 | 18 | $0.3800 | $1.14 | $0.2850 | $5.13
24 | Inductor | FIXED IND 2.2NH 400MA 120 MOHM | L1 | IND 0402 | BSCH001005052N2SCP | Chilisin Electronics | --------- | 2.2nH | Digikey (https://www.digikey.com/en/products/detail/chilisin-electronics/BSCH001005052N2SCP/10508713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) | 1 | 6 | $0.1000 | $0.10 | $0.1000 | $0.60
25 |  | 1515 Inductors (SMD) ROHS | L2, L4 | Custom | LQH44PN470MJ0L | Murata Electronics | --------- | 47uH | Digikey (https://www.digikey.com/en/products/detail/murata-electronics/LQH44PN470MJ0L/4359245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) | 2 | 12 | $0.4500 | $0.90 | $0.3960 | $4.75
26 |  | IND SMD 22uH 1.6A 20%, T&R | L3, L7 | Custom | NRS6045T220MMGK | Taiyo Yuden | ------- | 22uH | Digikey (https://www.digikey.com/en/products/detail/taiyo-yuden/NRS6045T220MMGK/2665990) | 2 | 12 | $0.4100 | $0.82 | $0.3650 | $4.38
27 |  | FIXED IND 1UH 2.5A 43.2 MOHM SMD | L5 | Custom | LQH32PN1R0NNCL | Murata Electronics | ------- | 1uH | Digikey (https://www.digikey.com/en/products/detail/murata-electronics/LQH32PN1R0NNCL/4359457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) | 1 | 6 | $0.4800 | $0.48 | $0.4800 | $2.88
28 |  | FIXED IND 2.2UH 3.25A 61 MOHM | L6 | Custom | 74437324022 | Würth Elektronik | ------- | 2.2uH | Digikey (https://www.digikey.com/en/products/detail/w%C3%BCrth-elektronik/74437324022/2791045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) | 1 | 6 | $2.2000 | $2.20 | $2.2000 | $13.20
29 |  | IND SMD 33 H 20% 500mA Idc | L8 | Custom | CBC3225T330KR | Taiyo Yuden | ------- | 33uH | Digikey (https://www.digikey.com/en/products/detail/taiyo-yuden/CBC3225T330KR/2763320) | 1 | 6 | $0.3000 | $0.30 | $0.3000 | $1.80
30 | LED | LED BLUE CLEAR CHIP SMD 0402 | LED4, LED5 | LED 0402 | APHHS1005QBC/D | Kingbright | ------- | ------- | Digikey (https://www.digikey.com/en/products/detail/kingbright/APHHS1005QBC-D/2263568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) | 2 | 12 | $0.5400 | $1.08 | $0.3310 | $3.97
31 | Mic | MIC COND ANALOG OMNI -38DB 6MM D | MK1 | -------- | POM-2738P-R | PUI Audio, Inc. | ------- | ------- | Digikey (https://www.digikey.com/en/products/detail/pui-audio-inc/POM-2738P-R/1464897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) | 1 | 6 | $2.1000 | $2.10 | $2.1000 | $12.60
32 | Mosfet | TRANS NPN 40V 200MA SOT23-3 | Q1, Q2, Q4, Q5, Q7 | SOT-23 | MMBT3904 | NTE Electronics, Inc | ------- | ------- | Digikey (https://www.digikey.com/en/products/detail/nte-electronics-inc/MMBT3904/11649623) | 5 | 30 | $0.1080 | $0.54 | $0.1080 | $3.24
33 |  | P-Channel -12V 4.1A 900mV @ 250uA 45mΩ @ 3.5A,4.5V 350mW SOT-23(SOT-23-3) MOSFET RoHS | Q3, Q6 | SOT-23 | CJ2305 |  |  | ------- |  | 2 | 12 | $1.4300 | $2.86 | $1.2600 | $15.12
34 |  | MOSFET 20V 2.0A 0.9W | Q8 | SOT-23-3 | SI2301BDS-T1-E3 | Vishay Siliconix | ------- | ------- | Digikey (https://www.digikey.com/en/products/detail/vishay-siliconix/SI2301BDS-T1-E3/1656335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) | 1 | 6 | $0.4200 | $0.42 | $0.4200 | $2.52
35 | Resistor | RES SMD 680 OHM 5% 1/20W 0201 | R1, R3, R71 | Res-0201 | RC0201JR-07680RL | YAGEO | ------- | 680R | Digikey (https://www.digikey.com/en/products/detail/yageo/RC0201JR-07680RL/1948962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) | 3 | 18 | $0.1000 | $0.30 | $0.0290 | $0.52
36 |  | RES SMD 5.6K OHM 1% 1/20W 0201 | R2 | Res-0201 | RC0201FR-075K6L | YAGEO | ------- | 5.6K | Digikey (https://www.digikey.com/en/products/detail/yageo/RC0201FR-075K6L/3202417) | 1 | 6 | $0.1000 | $0.10 | $0.1000 | $0.60
37 |  | RES SMD 100 OHM 1% 1/20W 0201 | R4, R5, R25, R26, R30, R32, R33, R35, R60, R83, R84 | Res-0201 | AC0201FR-07100RL | YAGEO | ------- | 100R | Digikey (https://www.digikey.com/en/products/detail/yageo/AC0201FR-07100RL/5894218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) | 11 | 66 | $0.1000 | $1.10 | $0.0660 | $4.36
38 |  | RES SMD 0 OHM JUMPER 1/20W 0201 | R6, R24, R81 | Res-0201 | RC0201JR-070RL | YAGEO | ------- | 0R | Digikey (https://www.digikey.com/en/products/detail/yageo/RC0201JR-070RL/1948898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) | 3 | 18 | $0.1000 | $0.30 | $0.0360 | $0.65
39 |  | RES SMD 10K OHM 1% 1/20W 0201 | R7, R8, R9, R10, R15, R17, R20, R31, R34, R39, R69, R74, R89, R91, R93, R95, R97, R99, R101, R103, R131 | Res-0201 | RC0201FR-0710KL | YAGEO | ------- | 10K | Digikey (https://www.digikey.com/en/products/detail/yageo/RC0201FR-0710KL/1948870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) | 21 | 126 | $0.1000 | $2.10 | $0.0420 | $5.29
40 |  | RES SMD 47K OHM 5% 1/20W 0201 | R11, R16, R22, R70, R135 | Res-0201 | RC0201JR-0747KL | YAGEO | ------- | 47K | Digikey (https://www.digikey.com/en/products/detail/yageo/RC0201JR-0747KL/1948954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) | 5 | 30 | $0.1000 | $0.50 | $0.0290 | $0.87
41 |  | RES SMD 100K OHM 5% 1/20W 0201 | R12, R18, R68, R73, R128, R130, R133 | Res-0201 | RC0201JR-07100KL | YAGEO | ------- | 100K | Digikey (https://www.digikey.com/en/products/detail/yageo/RC0201JR-07100KL/1948899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) | 7 | 42 | $0.1000 | $0.70 | $0.0290 | $1.22
42 |  | RES 4.7K OHM 1% 1/20W 0201 | R13, R134 | Res-0201 | RMCF0201FT4K70 | Stackpole Electronics Inc | ------- | 4.7K | Digikey (https://www.digikey.com/en/products/detail/stackpole-electronics-inc/RMCF0201FT4K70/1715026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) | 2 | 12 | $0.1000 | $0.20 | $0.0270 | $0.32
43 |  | RES SMD 300 OHM 5% 1/20W 0201 | R14 | Res-0201 | ERJ-1GNJ301C | Panasonic | ------- | 300R | Digikey (https://www.digikey.com/en/products/detail/panasonic-electronic-components/ERJ-1GNJ301C/2035774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) | 1 | 6 | $0.1000 | $0.10 | $0.1000 | $0.60
44 |  | RES SMD 5.1K OHM 1% 1/20W 0201 | R19, R132 | Res-0201 | AC0201FR-075K1L | YAGEO | ------- | 5.1K | Digikey (https://www.digikey.com/en/products/detail/yageo/AC0201FR-075K1L/5894738) | 2 | 12 | $0.1000 | $0.20 | $0.0660 | $0.79
45 |  | Res SMD 11.8K Ohm 1% 1/10W 0603 | R21 | Res0603 | AC0603FR-0711K8L | YAGEO | ------- | 11K8 | Digikey (https://www.digikey.com/en/products/detail/yageo/AC0603FR-0711K8L/5895754) | 1 | 6 | $0.1000 | $0.10 | $0.1000 | $0.60
46 |  | RES SMD 470 OHM 5% 1/20W 0201 | R23, R82 | Res-0201 | RC0201JR-07470RL | YAGEO | ------- | 470R | Digikey (https://www.digikey.com/en/products/detail/yageo/RC0201JR-07470RL/1948953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) | 2 | 12 | $0.1000 | $0.20 | $0.0290 | $0.35
47 |  | RES SMD 33 OHM 1% 1/20W 0201 | R27 | Res-0201 | AC0201FR-0733RL | YAGEO | ------- | 33R | Digikey (https://www.digikey.com/en/products/detail/yageo/AC0201FR-0733RL/5894558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) | 1 | 6 | $0.1000 | $0.10 | $0.1000 | $0.60
48 |  | PANASONIC - ERJ3EKF7321V - RES, 7K32, 1%, 0.1W, 0603, THICK FILM | R28 | Res0603 | ERJ3EKF7321V | Panasonic | ------- | 7.32K | Digikey (https://www.digikey.com/en/products/detail/panasonic-electronic-components/ERJ-3EKF7321V/196457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) | 1 | 6 | $0.1000 | $0.10 | $0.1000 | $0.60
49 |  | RES SMD 1K OHM 1% 1/20W 0201 | R29, R36, R37, R67 | Res-0201 | RC0201FR-071KL | YAGEO | ------- | 1K | Digikey (https://www.digikey.com/en/products/detail/yageo/RC0201FR-071KL/3202389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) | 4 | 24 | $0.1000 | $0.40 | $0.0420 | $1.01
50 |  | RES SMD 2.2K OHM 5% 1/20W 0201 | R38, R40 | Res-0201 | AC0201JR-072K2L | YAGEO | ------- | 2.2K | Digikey (https://www.digikey.com/en/products/detail/yageo/AC0201JR-072K2L/5894936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) | 2 | 12 | $0.1000 | $0.20 | $0.0490 | $0.59
51 |  | RES 4.99 OHM 1% 1/8W 0603 | R41 | Res0603 | RK73H1JTTD4R99F | KOA Speer Electronics, Inc. | ------- | 4R99 | Digikey (https://www.digikey.com/en/products/detail/koa-speer-electronics-inc/RK73H1JTTD4R99F/9845103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) | 1 | 6 | $0.1000 | $0.10 | $0.1000 | $0.60
52 |  | RES SMD 1M OHM 1% 1/20W 0201 | R42 | Res-0201 | RC0201FR-071ML | YAGEO | ------- | 1M | Digikey (https://www.digikey.com/en/products/detail/yageo/RC0201FR-071ML/3202390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) | 1 | 6 | $0.1000 | $0.10 | $0.1000 | $0.60
53 |  | RES ARRAY 4 RES 47K OHM 0804 | R61 | Custom | CAY10-473J4LF | Bourns Inc. | ------- | 47K | Digikey (https://www.digikey.com/en/products/detail/bourns-inc/CAY10-473J4LF/3593231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) | 1 | 6 | $0.1200 | $0.12 | $0.1200 | $0.72
54 |  | RES SMD 6.8K OHM 1% 1/20W 0201 | R66 | Res-0201 | AC0201FR-076K8L | YAGEO | ------- | 6.8K | Digikey (https://www.digikey.com/en/products/detail/yageo/AC0201FR-076K8L/5894794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) | 1 | 6 | $0.1000 | $0.10 | $0.1000 | $0.60
55 |  | RES SMD 510K OHM 1% 1/20W 0201 | R72 | Res-0201 | RC0201FR-07510KL | YAGEO | ------- | 510K | Digikey (https://www.digikey.com/en/products/detail/yageo/RC0201FR-07510KL/5280573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) | 1 | 6 | $0.1000 | $0.10 | $0.1000 | $0.60
56 |  | RES SMD 20K OHM 1% 1/20W 0201 | R75 | Res-0201 | RC0201FR-0720KL | YAGEO | ------- | 20K | Digikey (https://www.digikey.com/en/products/detail/yageo/RC0201FR-0720KL/3202392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) | 1 | 6 | $0.1000 | $0.10 | $0.1000 | $0.60
57 |  | RES SMD 1.1M OHM 5% 1/20W 0201 | R76 | Res-0201 | RC0201JR-071M1L | YAGEO | ------- | 1.1M | Digikey (https://www.digikey.com/en/products/detail/yageo/RC0201JR-071M1L/5280728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) | 1 | 6 | $0.1000 | $0.10 | $0.1000 | $0.60
58 |  | TNPW0201 50R 0.5% T-9 ET7 E3 | R77, R78, R79, R80 | Res-0201 | TNPW020150R0DEED | Vishay Dale | ------- | 50R | Digikey (https://www.digikey.com/en/products/detail/vishay-dale/TNPW020150R0DEED/13420998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) | 4 | 24 | $0.4000 | $1.60 | $0.3040 | $7.30
59 |  | RES 402K OHM 1% 1/20W 0201 | R126 | Res-0201 | RMCF0201FT402K | Stackpole Electronics Inc | ------- | 402K | Digikey (https://www.digikey.com/en/products/detail/stackpole-electronics-inc/RMCF0201FT402K/5965988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) | 1 | 6 | $0.1000 | $0.10 | $0.1000 | $0.60
60 |  | RES SMD 270K OHM 1% 1/20W 0201 | R127 | Res-0201 | RC0201FR-07270KL | YAGEO | ------- | 270K | Digikey (https://www.digikey.com/en/products/detail/yageo/RC0201FR-07270KL/5280408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) | 1 | 6 | $0.1000 | $0.10 | $0.1000 | $0.60
61 |  | RES SMD 536K OHM 1% 1/20W 0201 | R129 | Res-0201 | RC0201FR-07536KL | YAGEO | ------- | 536K | Digikey (https://www.digikey.com/en/products/detail/yageo/RC0201FR-07536KL/5280580) | 1 | 6 | $0.1000 | $0.10 | $0.1000 | $0.60
62 | IC | Single I2S/PCM Interface, Stereo, 2.3W Mono Amp, 45mW Headphone Amp | U1 | 32-QFN | ALC5621 | Realtek Semicon | ------- | ------ |  | 1 | 6 | $10.4655 | $10.47 | $10.4655 | $62.79
63 |  | IC REG LINEAR 1.8V 250MA SOT23-3 | U2, U11 | SOT-23 | S-1206B18-M3T1U | ABLIC U.S.A. Inc. | ------- | ------ | Digikey (https://www.digikey.com/en/products/detail/ablic-u-s-a-inc/S-1206B18-M3T1U/6114629) | 2 | 12 | $0.3766 | $0.75 | $0.3766 | $4.52
64 |  | RF Components | U3 |  | SIM7100AS2-10671 |  |  | ------ |  | 1 | 6 |  | $0.00 |  | $0.00
65 |  | S5P4418 Quad Core Android SoM System on Module | U4 |  | S5P4418 |  |  | ------ |  | 1 | 6 |  | $0.00 |  | $0.00
66 |  | IMU ACCEL/GYRO/COMPI2C/SPI 24QFN | U5 | 24-QFN (3x3) | ICM-20948 | TDK InvenSense | ------- | ------ | Digikey (https://www.digikey.com/en/products/detail/tdk-invensense/ICM-20948/6623535) | 1 | 6 | $11.5200 | $11.52 | $11.5200 | $69.12
67 |  | SENSOR OPT 550NM AMBIENT 6SMD | U6 | 6-SMD | VEML6030-GS15 | Vishay Semiconductor Opto Division | ------- | ------ | Digikey (https://www.digikey.com/en/products/detail/vishay-semiconductor-opto-division/VEML6030-GS15/6221149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) | 1 | 6 | $2.4200 | $2.42 | $2.4200 | $14.52
68 |  | Realtek RTL8723BU Combo Module | U7 |  | F23BUUM13-W2 |  |  |  |  | 1 | 6 |  | $0.00 |  | $0.00
69 |  | NXP - PCA9534BS3,118 - I/O EXPANDER, 8BIT, 400KHZ, HVQFN-16 | U8 | 16HVQFN | PCA9534BS3,118 | NXP USA Inc. | ------- | ------ | Digikey (https://www.digikey.com/en/products/detail/nxp-usa-inc/PCA9534BS3-118/1692868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) | 1 | 6 | $1.6100 | $1.61 | $1.6100 | $9.66
70 |  | SOT-23-5 PMIC - Power Distribution Switches RoHS | U9 | SOT23-5 | SY6280AAC | Silergy Corp | ------- | ------ |  | 1 | 6 | $0.4700 | $0.47 | $0.4700 | $2.82
71 |  | USB 2.0 Hub Controller | U10 | SSOP-28 | GL850G | Genesys Logic | ------- | ------ |  | 1 | 6 | $1.2000 | $1.20 | $1.2000 | $7.20
72 |  | IC TRANSCEIVER FULL 2/2 20TSSOP | U12 | 20-TSSOP | SP3222EEY-L/TR | MaxLinear, Inc. | ------- | ------ | Digikey (https://www.digikey.com/en/products/detail/maxlinear-inc/SP3222EEY-L-TR/2471743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) | 1 | 6 | $1.7500 | $1.75 | $1.7500 | $10.50
73 |  |  | U13 | QFN-8 | ETA3451D2I-T |  |  |  |  | 1 | 6 |  | $0.00 |  | $0.00
74 |  | IC REG BOOST ADJ 2.7A TSOT23-6 | U14 | TSOT-23-6 | MP3221GJ-Z | Monolithic Power Systems Inc. | ------- | ------ | Digikey (https://www.digikey.com/en/products/detail/monolithic-power-systems-inc/MP3221GJ-Z/9554692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) | 1 | 6 | $1.9700 | $1.97 | $1.9700 | $11.82
75 |  | IC REG SW QUAD TFT LCD 24-QFN | U15 | 24-QFN | LT1942EUF#PBF | Analog Devices Inc. | ------- | ------ | Digikey (https://www.digikey.com/en/products/detail/analog-devices-inc/LT1942EUF-PBF/963074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) | 1 | 6 | $6.5800 | $6.58 | $6.5800 | $39.48
76 | Crystal | CRYSTAL 12.0000MHZ 18PF SMD | X1 | Custom | 8Z-12.000MAAJ-T | TXC CORPORATION | ------- | ------ | Digikey (https://www.digikey.com/en/products/detail/txc-corporation/8Z-12-000MAAJ-T/2627003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) | 1 | 6 | $1.1700 | $1.17 | $1.1700 | $7.02
77 | Switch | SWITCH TACTILE SPST-NO 0.05A 32V | SW1, SW2, SW3, SW4 | Custom | KMT021NGJLHS | C&K | ------- | ------ | Digikey (https://www.digikey.com/en/products/detail/c-k/KMT021-NGJ-LHS/2297276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) | 4 | 24 | $0.3000 | $1.20 | $0.2950 | $7.08
78 | Connector | CONN HEADER R/A 2POS 2.5MM | J1, J16, J17, J18, J19 | Custom | S2B-XH-A(LF)(SN) | JST Sales America Inc. | ------- | ------ | Digikey (https://www.digikey.com/en/products/detail/jst-sales-america-inc/S2B-XH-A-LF-SN/1651055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) | 5 | 30 | $0.1700 | $0.85 | $0.1460 | $4.38
79 |  | CONN JACK 4COND 3.5MM SMD R/A | J2 | Custom | SJ-43515TS-SMT-TR | CUI Devices | ------- | ------ | Digikey (https://www.digikey.com/en/products/detail/cui-devices/SJ-43515TS-SMT-TR/669723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) | 1 | 6 | $1.0700 | $1.07 | $1.0700 | $6.42
80 |  | CONN FFC TOP 24POS 0.50MM R/A | J3 | Custom | 0524352471 | Molex | ------- | ------ | Digikey (https://www.digikey.com/en/products/detail/molex/0524352471/2074146?s=N4IgTCBcDaIAwFYwBYDMTkHYCMIC6AvkA) | 1 | 6 | $2.2200 | $2.22 | $2.2200 | $13.32
81 |  | CONN FFC 22POS 0.50MM SMD | J4 | Custom | TF31-22S-0.5SH(800) | Hirose Electric Co Ltd | ------- | ------ | Digikey (https://www.digikey.com/en/products/detail/hirose-electric-co-ltd/TF31-22S-0-5SH-800/11204757) | 1 | 6 | $0.4600 | $0.46 | $0.4600 | $2.76
82 |  | CONN U.FL RCPT STR 50 OHM SMD | J5, J22, J23 | Custom | U.FL-R-SMT-1(80) | Hirose Electric Co Ltd | ------- | ------ | Digikey (https://www.digikey.com/en/products/detail/hirose-electric-co-ltd/U-FL-R-SMT-1-80/3978495) | 3 | 18 | $1.1900 | $3.57 | $1.1900 | $21.42
83 |  | DC Power Receptacle Jack 2.5A 2.5mm 6.5mm SMD Power Connectors RoHS | J6 | Custom | DC-005-5A-2.5-SMT | XKB Connectivity | ------- | ------ |  | 1 | 6 | $0.3200 | $0.32 | $0.3200 | $1.92
84 |  | CONN FFC BOTTOM 4POS 0.50MM R/A | J7 | Custom | 0527460471 | Molex | ------- | ------ | Digikey (https://www.digikey.com/en/products/detail/molex/0527460471/3044842?s=N4IgTCBcDaIAwFYwHYAsA2OrkEYQF0BfIA) | 1 | 6 | $0.7600 | $0.76 | $0.7600 | $4.56
85 |  |  | J8, J26 | SMD PAD | SMD PAD | ------- | ------- | ------ |  | 2 | 12 |  | $0.00 |  | $0.00 | Do not Mount
86 |  | CONN MICRO SD CARD PUSH-PULL R/A | J9 | Custom | 114-00841-68 | Amphenol ICC (Commercial Products) | ------- | ------ | Digikey (https://www.digikey.com/en/products/detail/amphenol-icc-commercial-products/114-00841-68/2187086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) | 1 | 6 | $1.4000 | $1.40 | $1.4000 | $8.40
87 |  | Conn FFC/FPC 50 POS 0.5mm SMD T/R | J10 | Custom | FH12A-50S-0.5SH(55) | Hirose Electric Co Ltd | ------- | ------ | Digikey (https://www.digikey.com/en/products/detail/hirose-electric-co-ltd/FH12A-50S-0-5SH-55/1110339) | 1 | 6 | $3.0000 | $3.00 | $3.0000 | $18.00
88 |  | USB Connectors 4P RECEPTACLE TYPE A | J12 | Custom | 87583-2010BLF | Amphenol ICC (FCI) | ------- | ------ | Digikey (https://www.digikey.com/en/products/detail/amphenol-icc-fci/87583-2010BLF/2665595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) | 1 | 6 | $0.8800 | $0.88 | $0.8800 | $5.28
89 |  | CONN SMART CARD PUSH-PULL | J15 | Custom | 693043020611 | Würth Elektronik | ------- | ------ | Digikey (https://www.digikey.com/en/products/detail/w%C3%BCrth-elektronik/693043020611/5047817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) | 1 | 6 | $1.6900 | $1.69 | $1.6900 | $10.14
90 |  | USB - Micro B Female USB 2 5 SMD USB Connectors RoHS | J21 | 10118194-0001LF | 10118194-0001LF | Amphenol ICC (FCI) | ------- | ------ | Digikey (https://www.digikey.com/en/products/detail/amphenol-icc-fci/10118194-0001LF/2785389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) | 1 | 6 | $0.4500 | $0.45 | $0.4500 | $2.70
91 |  | CONN D-SUB RCPT 9POS R/A SOLDER | J25 | A-DF 09 A/KG-T4S | A-DF 09 A/KG-T4S | Assmann WSW Components | ------- | ------ | Digikey (https://www.digikey.com/en/products/detail/assmann-wsw-components/A-DF-09-A-KG-T4S/1241802) | 1 | 6 | $0.8200 | $0.82 | $0.8200 | $4.92
92 |  | Solder Bridge ON | SB1, SB2, SB3, SB4, SB5, SB6, SB9, SB10, SB? | Solder Bridge | Solder Bridge | ------- | ------ | ------ | ------ | 9 | 54 | ------ | #VALUE! | ------ | #VALUE! | Do not Mount
93 |  | Test Point ON | P1, P2 | TEST POINT | TEST POINT | ------- | ------ | ------ | ------ | 2 | 12 | ------ | #VALUE! | ------ | #VALUE! | Do not Mount
