eSpark-Backup/tonyajode-tabletdesign/Deliverables/Core Production Files/Renderings/Tablet_Design.DXF

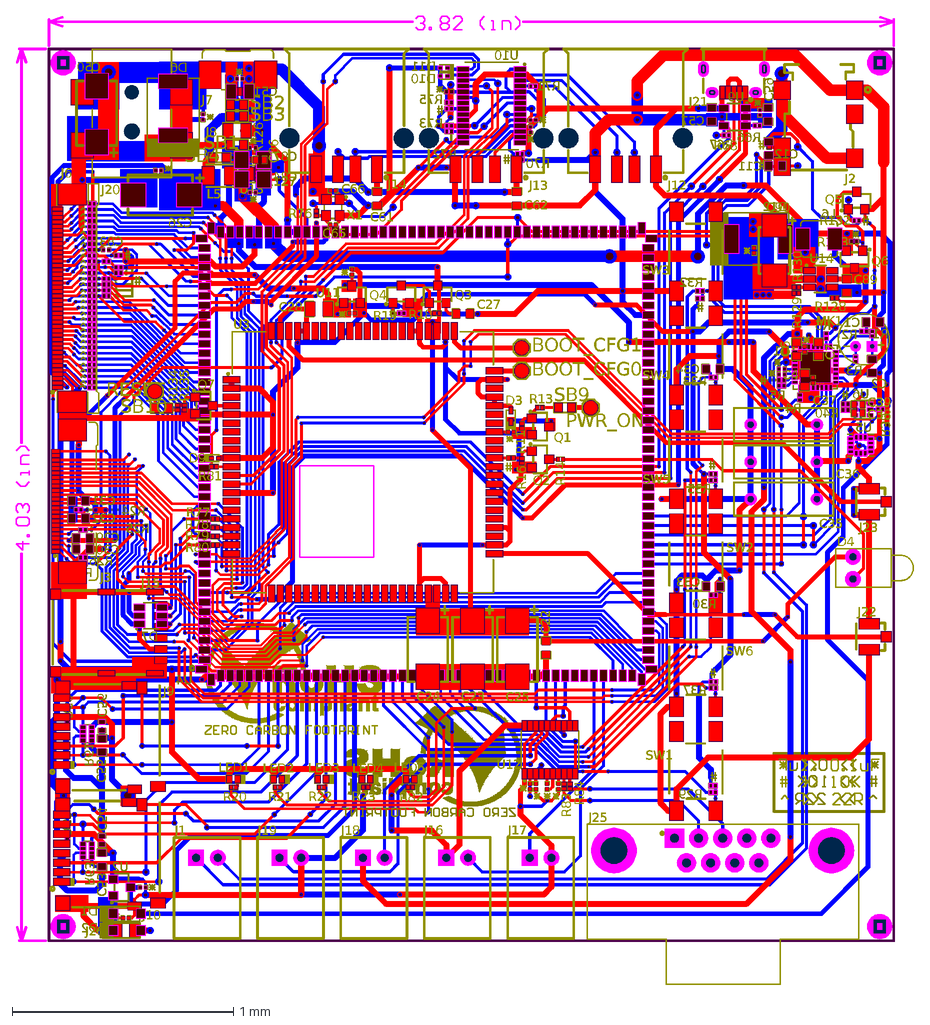
[picture p41: CAD file, 2021-07-18]
Deliverables/Core Production Files/Renderings/Tablet_Design.DXF
BOOT_CFG1
BOOT_CFG0
PWR_ON
RESET
J2
D4
R14
J15
C37
C36
C35
U4
R126
U14
U13
U12
U2
SB10
SB9
R135
R134
R133
R132
R130
R129
R128
R127
R84
R83
R68
R13
Q7
Q6
Q5
L6
L5
J26
J25
J23
J22
J21
J20
J19
J18
J17
J16
D12
C90
C89
C87
C86
C84
C83
C26
C25
R11
Q1
LED5
LED4
LED3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
