eSpark-Backup/tonyajode-tabletdesign/(list of files, cad)

Other CAD files:
Deliverables/Core Production Files/Renderings/Tablet_Design.DWG
