eSpark-Backup/tonyajode-tabletdesign/(list of files, drawings)

Other design files:
Design-Files/3G_Modem.SchDoc
Design-Files/3G_Section.SchDoc
Design-Files/7'' LCD Connector.SchDoc
Design-Files/7''_LCD_Connector.SchDoc
Design-Files/Audio_Codec_Sec.SchDoc
Design-Files/Audio_Section.SchDoc
Design-Files/Batt_Conn.SchDoc
Design-Files/BLE&WiFi_Section.SchDoc
Design-Files/Camera_Section.SchDoc
Design-Files/Connector_Section.SchDoc
Design-Files/Controller_Section.SchDoc
Design-Files/Headphones_Sec.SchDoc
Design-Files/Input_Section.SchDoc
Design-Files/Key_Buttons.SchDoc
Design-Files/LCD_Conn.SchDoc
Design-Files/LCD_Drive_Sec.SchDoc
Design-Files/LCD_Section.SchDoc
Design-Files/LED_Driver.SchDoc
Design-Files/Level_Shifter_Sec.SchDoc
Design-Files/Main_Cont.SchDoc
Design-Files/Main_Cont_2.SchDoc
Design-Files/Main_Cont_3.SchDoc
Design-Files/MCU_Core_Power.SchDoc
Design-Files/Memory_Section.SchDoc
Design-Files/MIC_Sec.SchDoc
Design-Files/Power_Section.SchDoc
Design-Files/RS-232 Tranceiver Section.SchDoc
Design-Files/RTC_Sec.SchDoc
Design-Files/SD_Card_2_Conn.SchDoc
Design-Files/SD_Card_Conn.SchDoc
Design-Files/Sensor_Section.SchDoc
Design-Files/Speaker_Sec.SchDoc
Design-Files/Task_Tony.PrjPcb
Design-Files/Top_Sheet.SchDoc
Design-Files/Touch_Screen_Cont.SchDoc
Design-Files/USB_Host.SchDoc
Design-Files/USB_OTG.SchDoc
Design-Files/USB_Power.SchDoc
Design-Files/USB_Sec.SchDoc
Design-Files/USIM_Sec.SchDoc
Library-Files/Tony_.PcbLib
Library-Files/Tony_.SchLib
