eSpark-Backup/tonyajode-tabletdesign/(commit log)

2021-07-18 Latest Files and Deliverables from Mars
    [3G_Modem.SchDoc, 3G_Section.SchDoc, 7'' LCD Connector.SchDoc, Audio_Codec_Sec.SchDoc, Audio_Section.SchDoc, Batt_Conn.SchDoc, Camera_Section.SchDoc, Connector_Section.SchDoc]
2021-07-29 Tablet Design Description Doc added.
    [Task_Tony.PrjPcb]
2021-08-04 UCM iMX8 description added and formattting updated in report. Extra SD card and USB conn removed in schematic.
    [Controller_Section.SchDoc, Headphones_Sec.SchDoc, Main_Cont_2.SchDoc, Memory_Section.SchDoc, Top_Sheet.SchDoc, USB_Host.SchDoc]
2021-08-05 Front camera link updated in Report.
    [Camera_Section.SchDoc]
2021-08-05 3G module connected to MCU. UC4689-A46 connections added.
    [3G_Modem.SchDoc, 3G_Section.SchDoc, Camera_Section.SchDoc, Controller_Section.SchDoc, Main_Cont.SchDoc, Task_Tony.PrjPcb, Top_Sheet.SchDoc]
2021-08-09 Rpi V.2 Cam connetions and BLE+Wifi module connections added. Components also added to library.
    [BLE&WiFi_Section.SchDoc, Camera_Section.SchDoc, Controller_Section.SchDoc, Main_Cont_3.SchDoc, Task_Tony.PrjPcb, Tony_.PcbLib, Tony_.SchLib, Top_Sheet.SchDoc]
2021-08-10 Added ICM-20948 and PCA9534BS3,118 to library and schematic.
    [3G_Modem.SchDoc, 3G_Section.SchDoc, BLE&WiFi_Section.SchDoc, Camera_Section.SchDoc, Controller_Section.SchDoc, Input_Section.SchDoc, Main_Cont.SchDoc, Sensor_Section.SchDoc]
2021-08-11 BLE connector added. Schematic errors removed.
    [BLE&WiFi_Section.SchDoc, Task_Tony.PrjPcb, Tony_.SchLib, USB_Sec.SchDoc]
2021-08-12 Schematic Review and update in PCB.
    [3G_Modem.SchDoc, 3G_Section.SchDoc, Audio_Codec_Sec.SchDoc, Audio_Section.SchDoc, BLE&WiFi_Section.SchDoc, Camera_Section.SchDoc, Connector_Section.SchDoc, Controller_Section.SchDoc]
2021-08-12 Design changes.
    [BLE&WiFi_Section.SchDoc, Key_Buttons.SchDoc, Sensor_Section.SchDoc, Tablet_Design.PcbDoc, Task_Tony.PrjPcb]
2021-08-12 Changes in Design.
    [3G_Modem.SchDoc, 3G_Section.SchDoc, Audio_Codec_Sec.SchDoc, Audio_Section.SchDoc, BLE&WiFi_Section.SchDoc, Camera_Section.SchDoc, Connector_Section.SchDoc, Controller_Section.SchDoc]
2021-08-13 Latest Schematic and PCB files Added.
    [3G_Modem.SchDoc, 3G_Section.SchDoc, Audio_Codec_Sec.SchDoc, Audio_Section.SchDoc, BLE&WiFi_Section.SchDoc, Camera_Section.SchDoc, Connector_Section.SchDoc, Controller_Section.SchDoc]
2021-08-13 Changes in PCB.
    [3G_Modem.SchDoc, 3G_Section.SchDoc, Audio_Codec_Sec.SchDoc, Audio_Section.SchDoc, BLE&WiFi_Section.SchDoc, Camera_Section.SchDoc, Connector_Section.SchDoc, Controller_Section.SchDoc]
2021-08-15 Library and PCB File updated.
    [3G_Modem.SchDoc, 3G_Section.SchDoc, Audio_Codec_Sec.SchDoc, Audio_Section.SchDoc, BLE&WiFi_Section.SchDoc, Camera_Section.SchDoc, Connector_Section.SchDoc, Controller_Section.SchDoc]
2021-08-16 Through hole capacitors replaced. 3D body of U10 added.
    [Sensor_Section.SchDoc, Task_Tony.PrjPcb, Tony_.PcbLib, USB_Host.SchDoc]
2021-08-17 KMT021NGJLHS added to lib and design. LED driver and FPC connector added to library.
    [Key_Buttons.SchDoc, Tony_.PcbLib, Tony_.SchLib]
2021-08-18 50 pin FPC, LED drive and charge pump circuit added to schematic. Library also updated.
    [7''_LCD_Connector.SchDoc, LCD_Drive_Sec.SchDoc, LCD_Section.SchDoc, Task_Tony.PrjPcb, Tony_.PcbLib, Tony_.SchLib, Top_Sheet.SchDoc, USB_Host.SchDoc]
2021-08-19 Added LT192 TFT driver to design.
    [7''_LCD_Connector.SchDoc, LCD_Drive_Sec.SchDoc, Task_Tony.PrjPcb, Tony_.PcbLib, Tony_.SchLib]
2021-08-20 TFT driver completed.
    [7''_LCD_Connector.SchDoc, Controller_Section.SchDoc, LCD_Drive_Sec.SchDoc, LCD_Section.SchDoc, Main_Cont_2.SchDoc, Tony_.PcbLib, Tony_.SchLib, Top_Sheet.SchDoc]
2021-08-23 Added ST4SI2M0020TPIFW and SMD pads for speakers.
    [7''_LCD_Connector.SchDoc, Audio_Codec_Sec.SchDoc, Camera_Section.SchDoc, Headphones_Sec.SchDoc, Tony_.PcbLib, Tony_.SchLib, USIM_Sec.SchDoc]
2021-08-23 Latest BOM
    [Digikey BOM_Tony Ajode.xlsx]
2021-08-30 UC200T added to Library and schematic.
    [3G_Modem.SchDoc, 3G_Section.SchDoc, Controller_Section.SchDoc, Main_Cont.SchDoc, Task_Tony.PrjPcb, Tony_.PcbLib, Tony_.SchLib, Top_Sheet.SchDoc]
2021-08-31 UART and debugging headers added. USB 2.0 added for programming UC200T.
    [3G_Modem.SchDoc, 3G_Section.SchDoc, BLE&WiFi_Section.SchDoc, Controller_Section.SchDoc, LCD_Section.SchDoc, Main_Cont.SchDoc, Tony_.PcbLib, Tony_.SchLib]
2021-09-06 USB C added for DC_IN
    [3G_Modem.SchDoc, Connector_Section.SchDoc, Tony_.PcbLib, Tony_.SchLib, USB_Power.SchDoc, USIM_Sec.SchDoc]
2021-09-06 Latest library
    [Tony_.PcbLib, Tony_.SchLib]
2021-09-06 smaller Res and Caps replaced with 0603 package.
    [3G_Modem.SchDoc, 7''_LCD_Connector.SchDoc, Audio_Codec_Sec.SchDoc, BLE&WiFi_Section.SchDoc, Connector_Section.SchDoc, Headphones_Sec.SchDoc, Key_Buttons.SchDoc, Level_Shifter_Sec.SchDoc]
2021-09-06 Updated files
    [Tony_.PcbLib, Tony_.SchLib]
2021-09-09 All resistors and caps changed to 0603 package. PCB updated.
    [3G_Modem.SchDoc, Audio_Codec_Sec.SchDoc, Camera_Section.SchDoc, Main_Cont.SchDoc, Main_Cont_2.SchDoc, Memory_Section.SchDoc, Sensor_Section.SchDoc, Tony_.SchLib]
2021-10-03 Changes in PCB done.
    [3G_Modem.SchDoc, 3G_Section.SchDoc, 7''_LCD_Connector.SchDoc, Audio_Codec_Sec.SchDoc, Audio_Section.SchDoc, BLE&WiFi_Section.SchDoc, Camera_Section.SchDoc, Connector_Section.SchDoc]
2021-10-04 C75, C15 and CF1 changed to 0603 package in 3G section.
    [3G_Modem.SchDoc, 7''_LCD_Connector.SchDoc, Controller_Section.SchDoc, LCD_Section.SchDoc, Main_Cont_2.SchDoc, Tony_Tablet.PcbDoc, Top_Sheet.SchDoc, USIM_Sec.SchDoc]
2021-11-01 Updated Library
    [Tony_.PcbLib, Tony_.SchLib]
2021-11-02 Updated library overlay and footprint issue part no issue me mention ho jayege.
    [Tony_.PcbLib, Tony_.SchLib]
2023-10-05 Old Files deleted.
    [Tablet_Design.PcbDoc, Tony_Tablet.PcbDoc]
